azouzkm/CO2-Hypoventilation-Monitor/docs/screenshots/README.md

# Dashboard screenshots (4 Nov 2026), one per display state

Browser bar cropped off; everything on the page is kept. Times are the Mac clock.

| File | State | What it shows |
| --- | --- | --- |
| dashboard_01_standby.png | Standby (white, spinning) | Not monitoring yet; 735 ppm; line connected (21:40:00) |
| dashboard_02_standby_warming_up.png | Standby, sensor warming up | 500 ppm warm-up placeholder after a replug (22:13:59) |
| dashboard_03_breathing_normal.png | Normal (green) | Exhaled CO2 present, no alarm (21:40:21) |
| dashboard_04_co2_lost_critical.png | Critical (red), with Acknowledge | "CO2 lost: fell 498 ppm from 5000 in under 20 s" (21:41:31) |
| dashboard_05_co2_lost_acknowledged.png | Critical, acknowledged | Acknowledged by AKM on the screen; the monitor confirmed its sound is off (21:41:32) |
| dashboard_06_line_off_technical.png | Technical (cyan): line off, with Acknowledge | Safety clip open; never shown as a patient alarm (21:40:30) |
| dashboard_07_line_off_acknowledged.png | Line off, acknowledged on the screen | Box sound acknowledged only at its button (21:40:36) |
| dashboard_08_sensor_top_of_range_technical.png | Technical (cyan): sensor at top of range, with Acknowledge | 5,000 ppm for 30 s: "the sensor cannot see breaths" (21:41:11) |
| dashboard_09_sensor_top_of_range_acknowledged.png | Top of range, acknowledged on the screen | (21:41:14) |
| dashboard_10_advisory_recorded_3nov.png | Advisory (amber), with Acknowledge | The advisory recorded on 3 Nov 2026, 18:36: "CO2 down 35 % (4847 -> 3653 ppm), for 30 s" |
| dashboard_11_advisory_recorded_3nov_acknowledged.png | Advisory, acknowledged on the screen | Same recorded advisory; sound off on the screen for 2 min |

Note: images 05, 09 and 11 have the macOS screenshot preview in the bottom-right corner, over the right end of the 10-minute chart.
