azouzkm/CO2-Hypoventilation-Monitor/docs/photos/2026-11-01_inside_case_clip_first_try.jpg

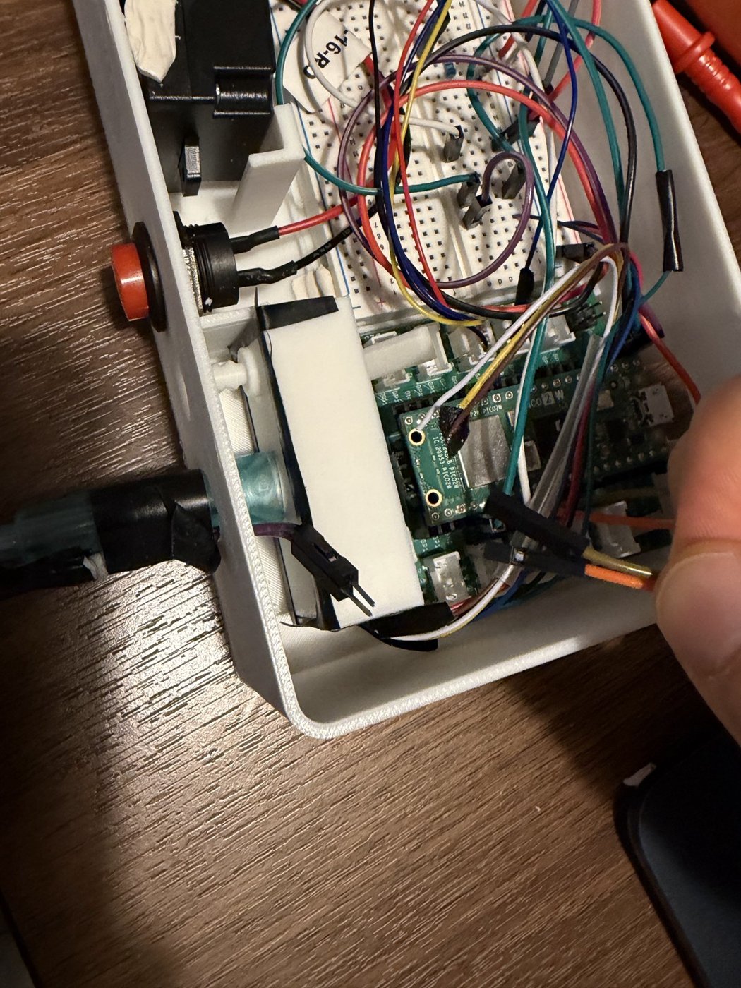
docs/photos/2026-11-01_inside_case_clip_first_try.jpg
