azouzkm/CO2-Hypoventilation-Monitor/docs/photos/2026-11-01_safety_clip_outside_front_panel.jpg

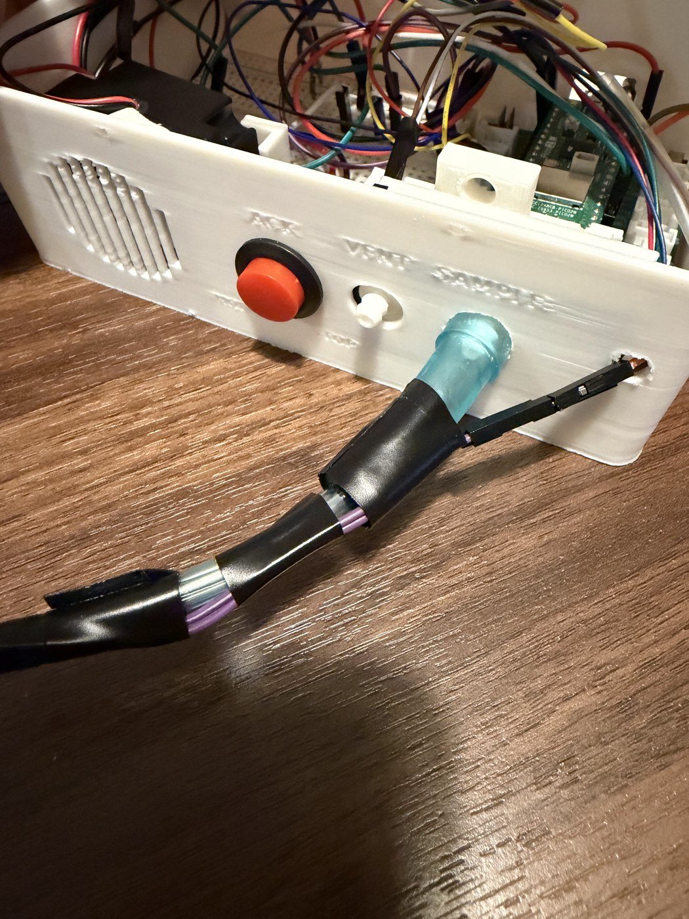
docs/photos/2026-11-01_safety_clip_outside_front_panel.jpg
