azouzkm/CO2-Hypoventilation-Monitor/docs/photos/2026-11-01_safety_clip_wires_to_shield.jpg

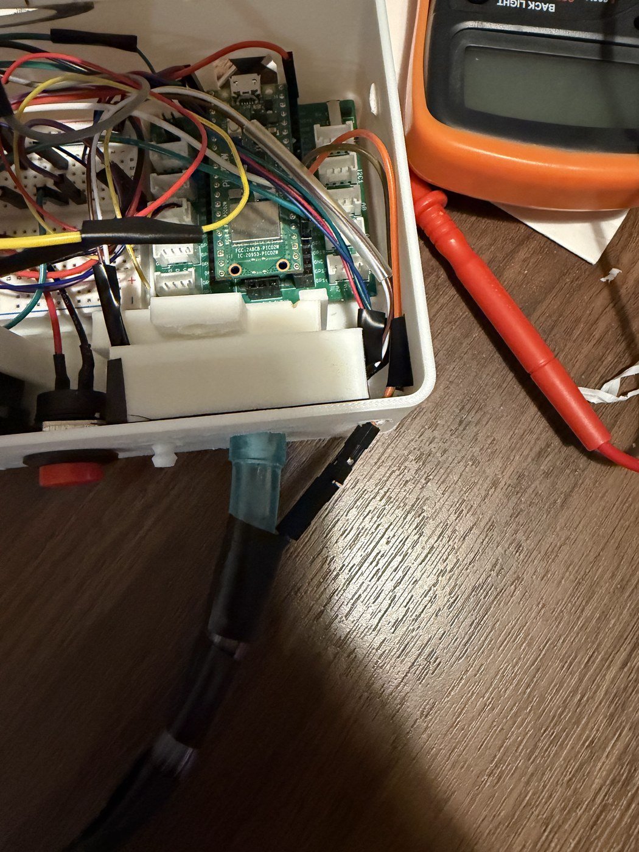
docs/photos/2026-11-01_safety_clip_wires_to_shield.jpg
