azouzkm/CO2-Hypoventilation-Monitor/docs/screenshots/dashboard_01_standby.png

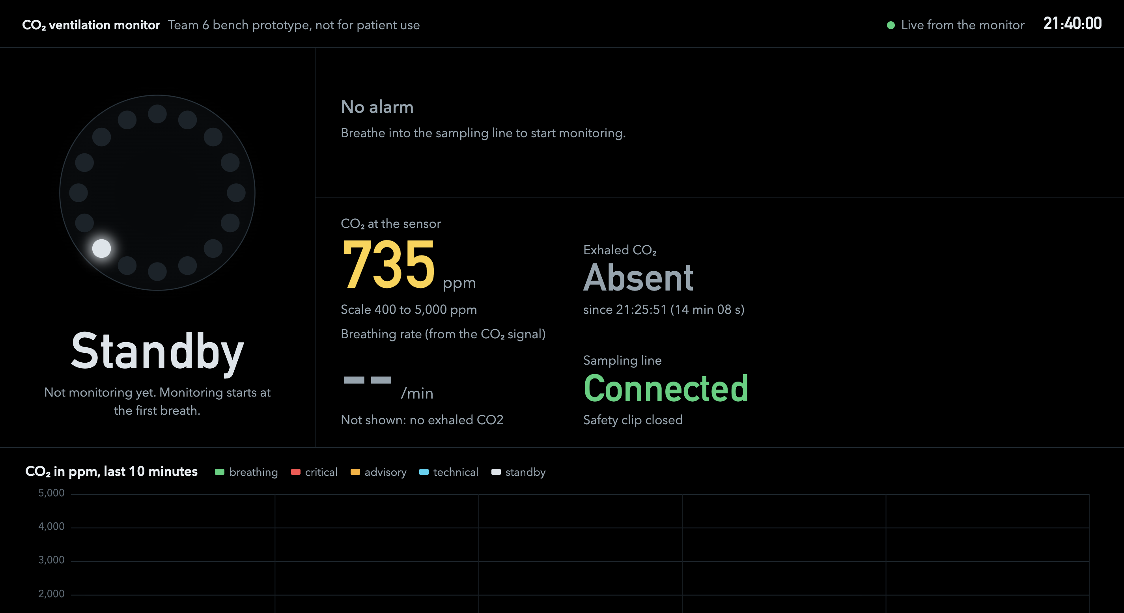
docs/screenshots/dashboard_01_standby.png
