azouzkm/CO2-Hypoventilation-Monitor/docs/screenshots/dashboard_02_standby_warming_up.png

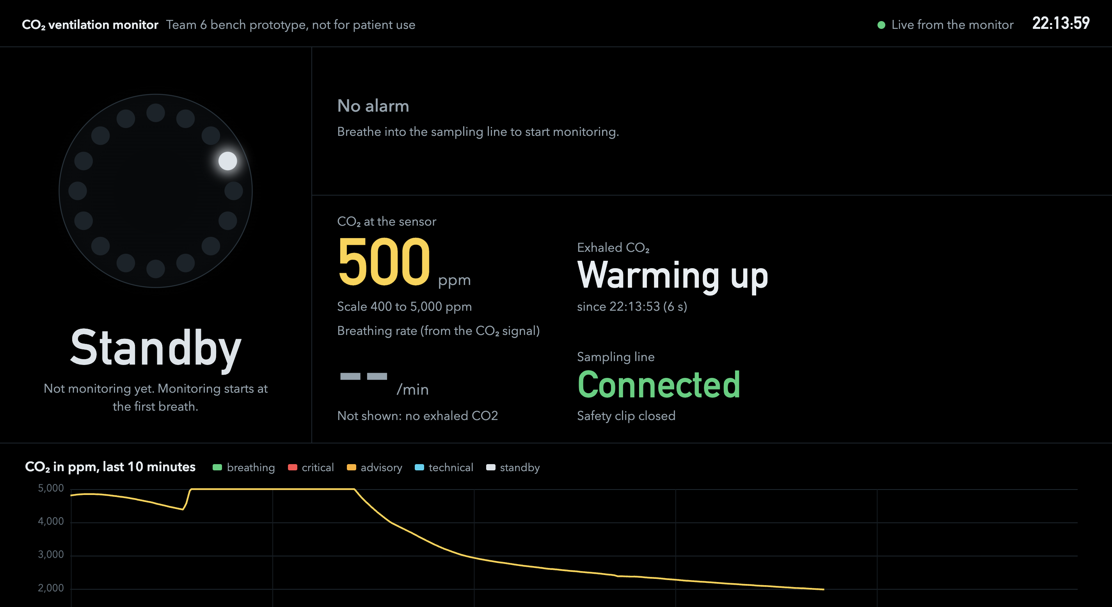
docs/screenshots/dashboard_02_standby_warming_up.png
