azouzkm/CO2-Hypoventilation-Monitor/docs/screenshots/dashboard_03_breathing_normal.png

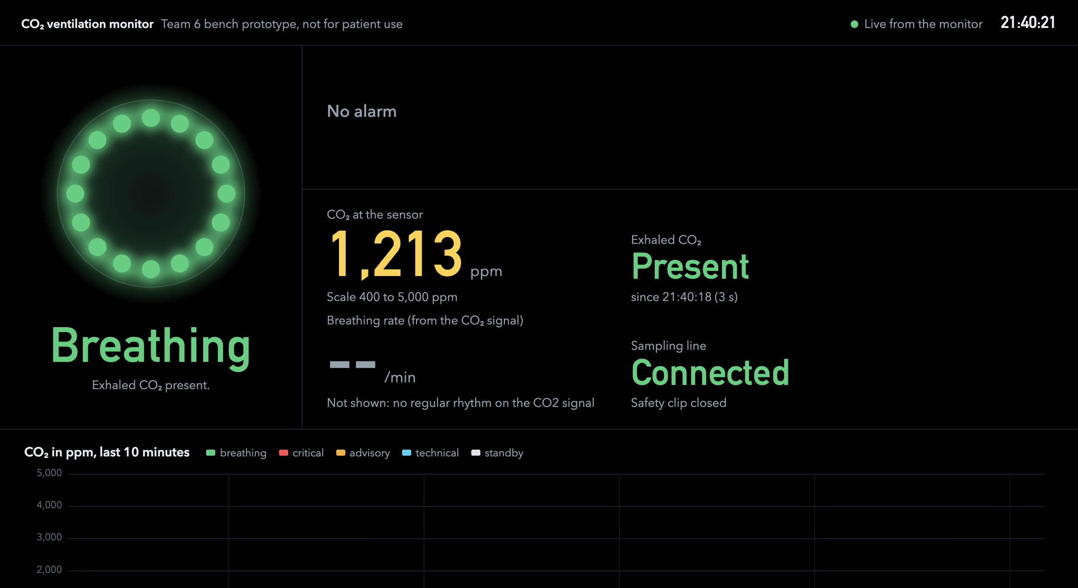
docs/screenshots/dashboard_03_breathing_normal.png
