azouzkm/CO2-Hypoventilation-Monitor/docs/screenshots/dashboard_04_co2_lost_critical.png

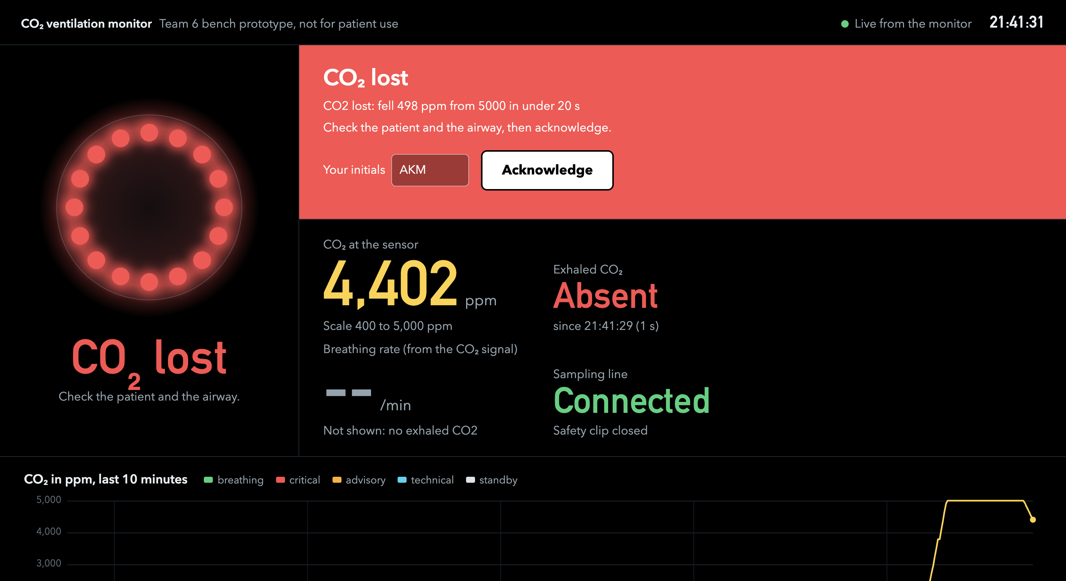
docs/screenshots/dashboard_04_co2_lost_critical.png
