azouzkm/CO2-Hypoventilation-Monitor/docs/screenshots/dashboard_05_co2_lost_acknowledged.png

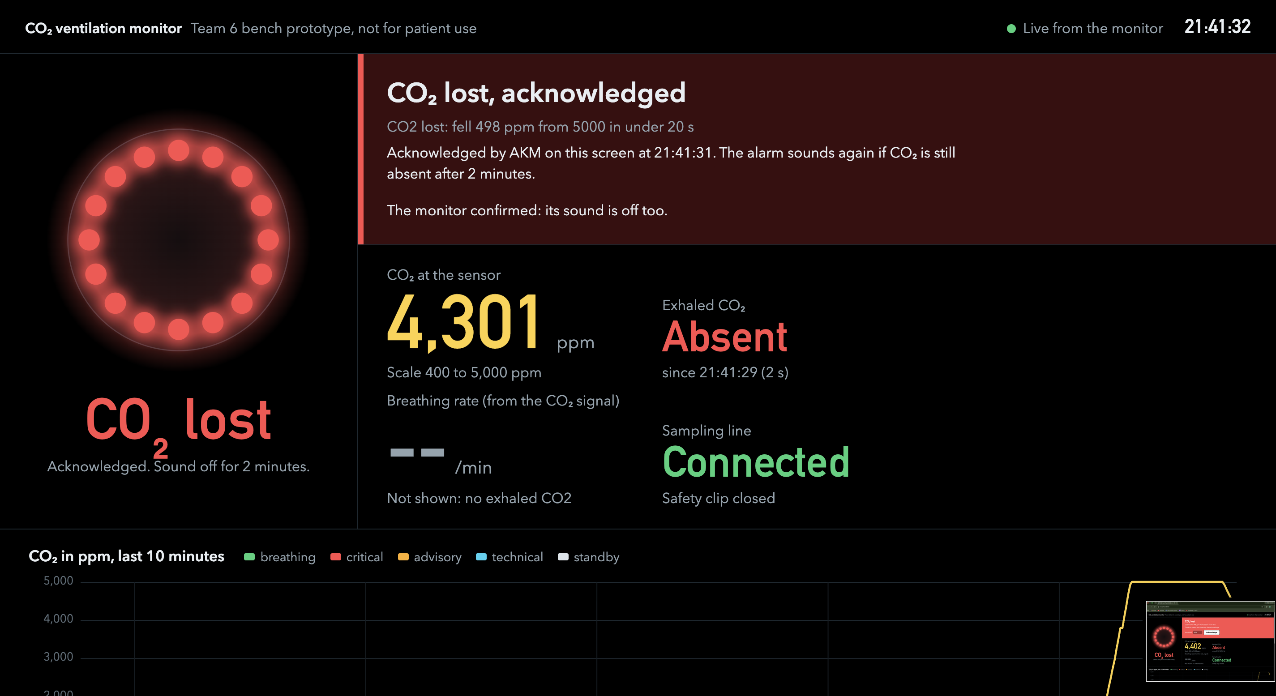
docs/screenshots/dashboard_05_co2_lost_acknowledged.png
