azouzkm/CO2-Hypoventilation-Monitor/docs/screenshots/dashboard_06_line_off_technical.png

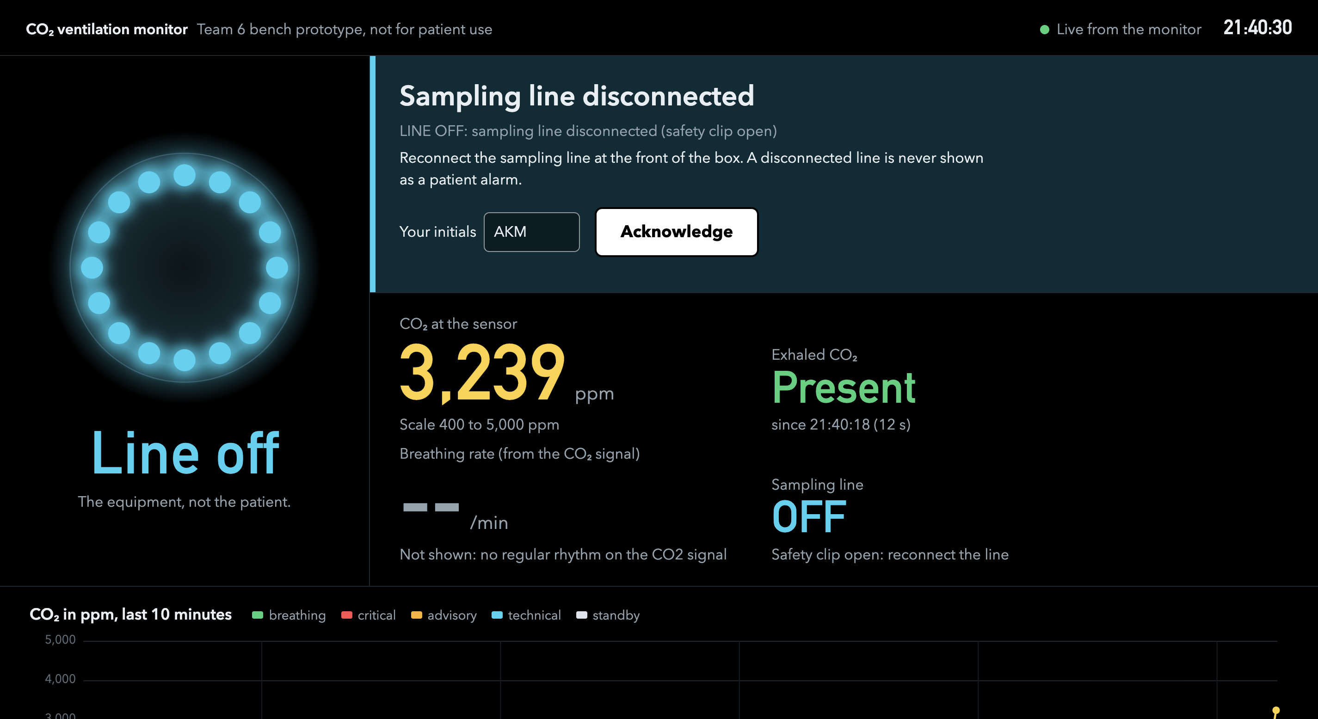
docs/screenshots/dashboard_06_line_off_technical.png
