azouzkm/CO2-Hypoventilation-Monitor/docs/screenshots/dashboard_07_line_off_acknowledged.png

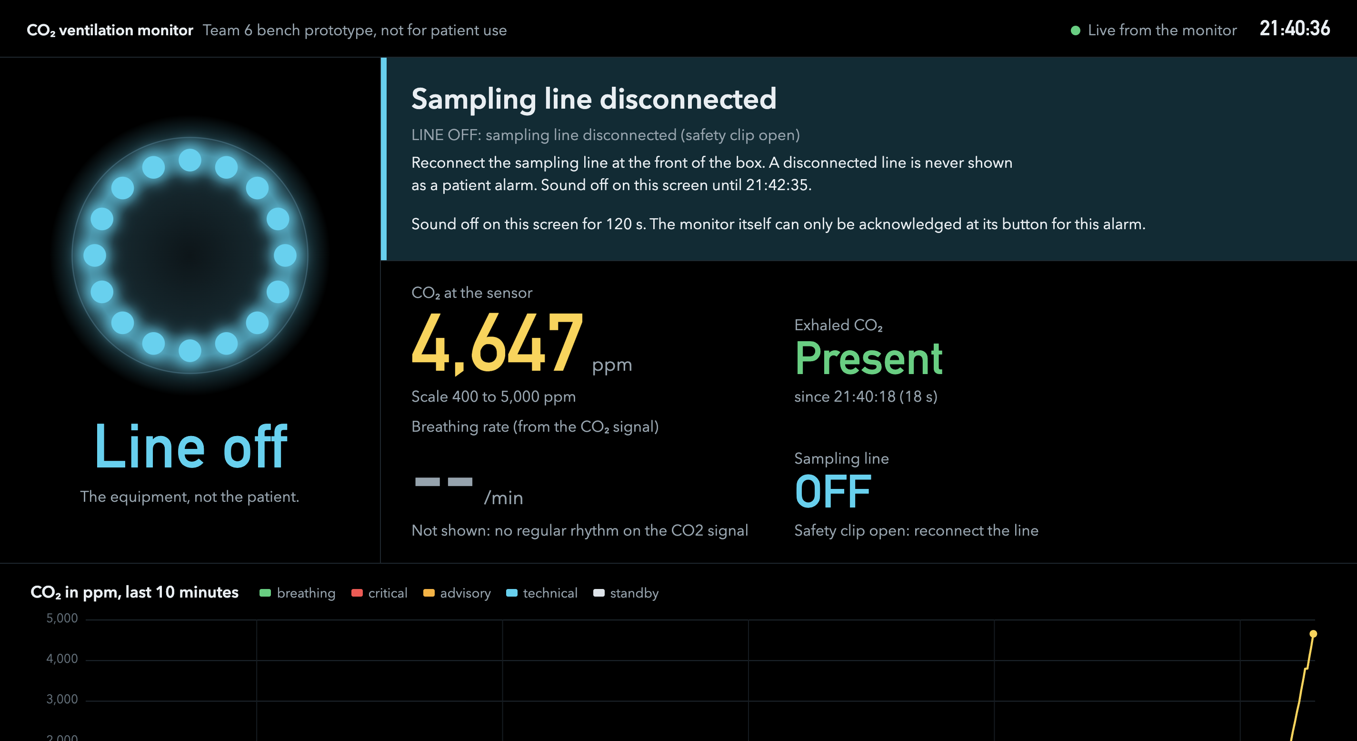
docs/screenshots/dashboard_07_line_off_acknowledged.png
