azouzkm/CO2-Hypoventilation-Monitor/docs/screenshots/dashboard_08_sensor_top_of_range_technical.png

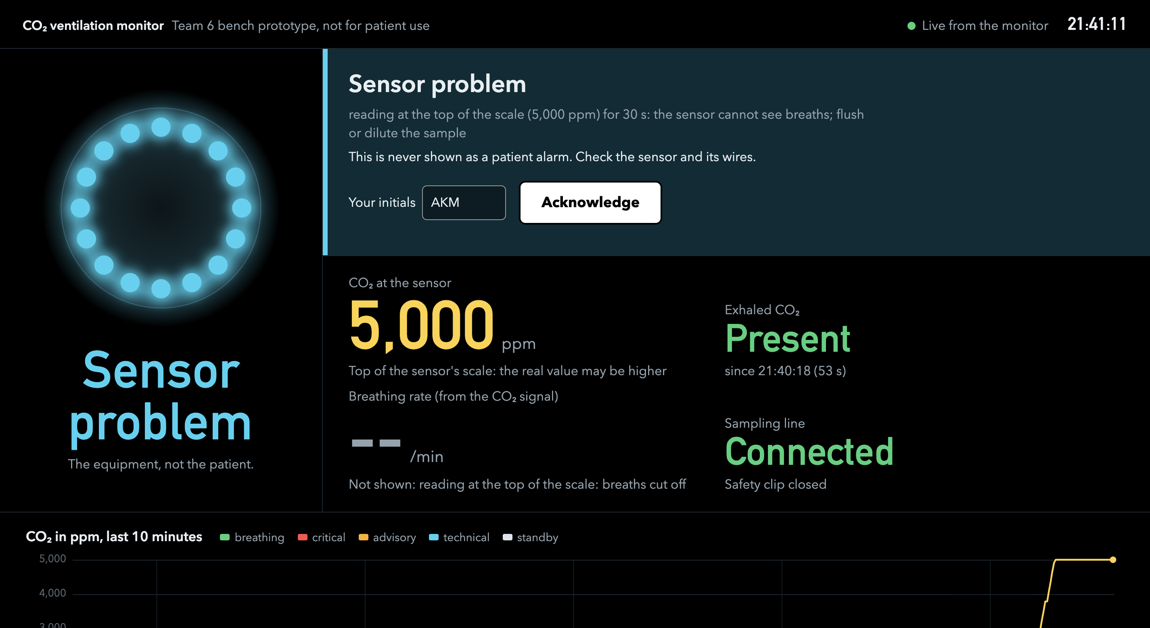
docs/screenshots/dashboard_08_sensor_top_of_range_technical.png
