azouzkm/CO2-Hypoventilation-Monitor/docs/screenshots/dashboard_09_sensor_top_of_range_acknowledged.png

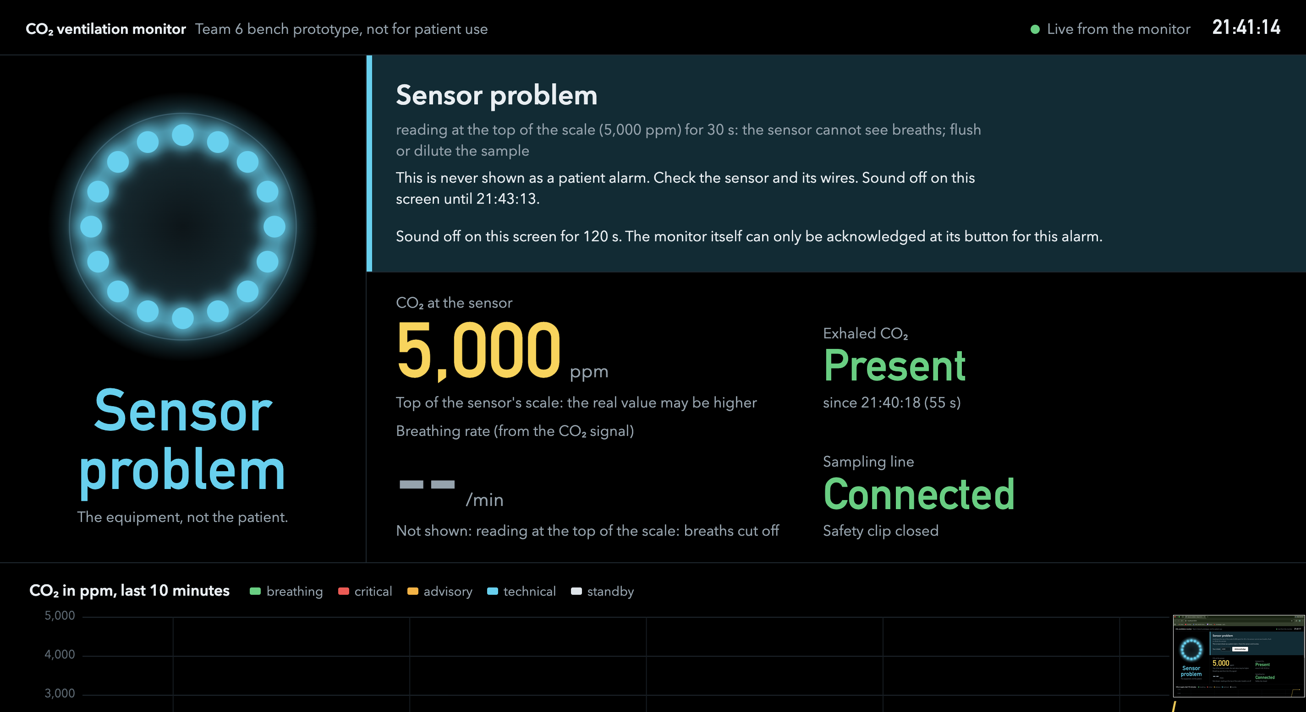
docs/screenshots/dashboard_09_sensor_top_of_range_acknowledged.png
