azouzkm/CO2-Hypoventilation-Monitor/docs/screenshots/dashboard_10_advisory_recorded_3nov.png

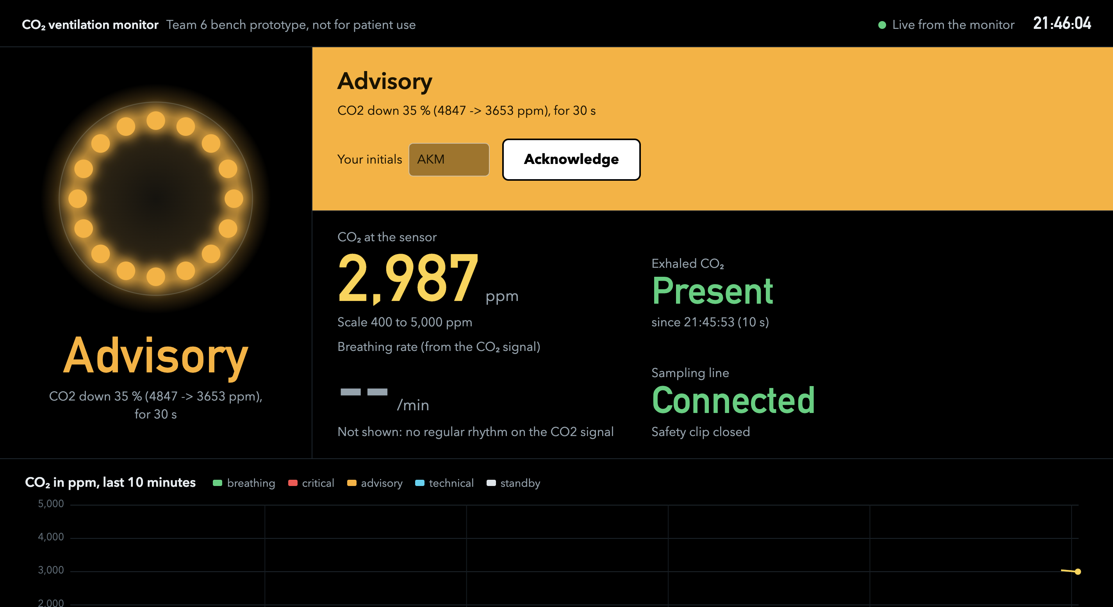
docs/screenshots/dashboard_10_advisory_recorded_3nov.png
