azouzkm/CO2-Hypoventilation-Monitor/docs/screenshots/dashboard_11_advisory_recorded_3nov_acknowledged.png

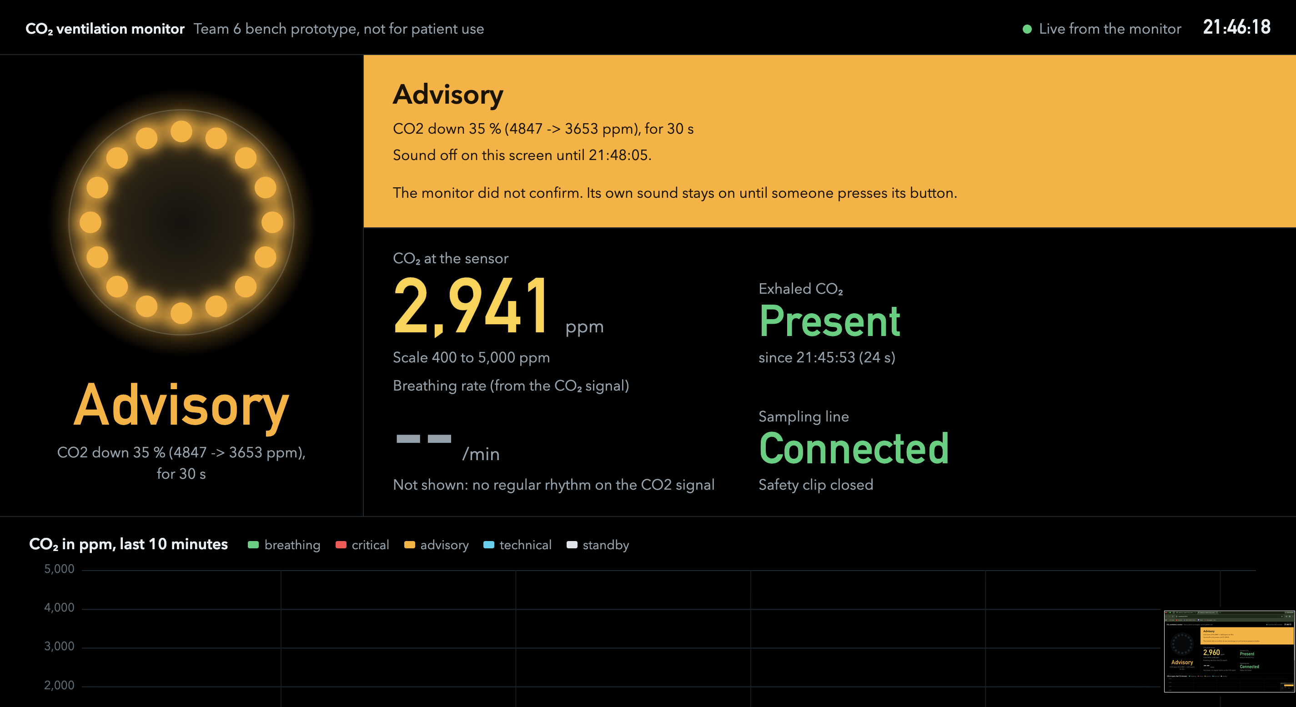
docs/screenshots/dashboard_11_advisory_recorded_3nov_acknowledged.png
