azouzkm/CO2-Hypoventilation-Monitor/hardware/cad/T6_cell_clamp_v1.step

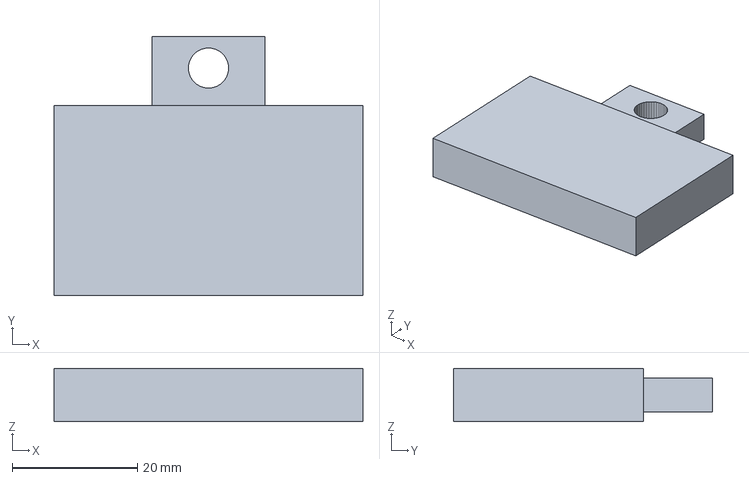
[picture p16: CAD file, 2026-11-05]
hardware/cad/T6_cell_clamp_v1.step
49.3 x 41.2 x 8.50 mm
