azouzkm/CO2-Hypoventilation-Monitor/hardware/cad/T6_light_cap_v1.step

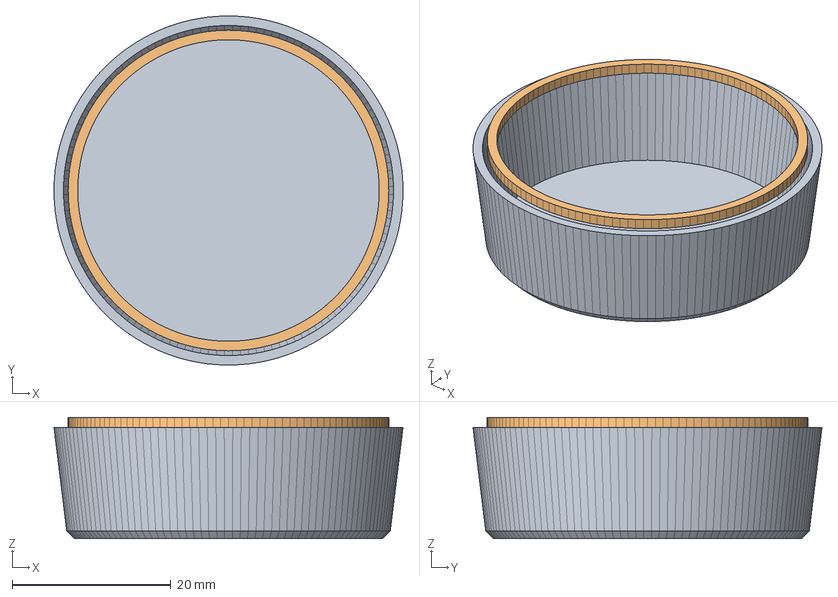
[picture p17: CAD file, 2026-11-05]
hardware/cad/T6_light_cap_v1.step
44.0 x 44.0 x 15.3 mm
