azouzkm/CO2-Hypoventilation-Monitor/hardware/cad/T6_caseA_lid_v1.step

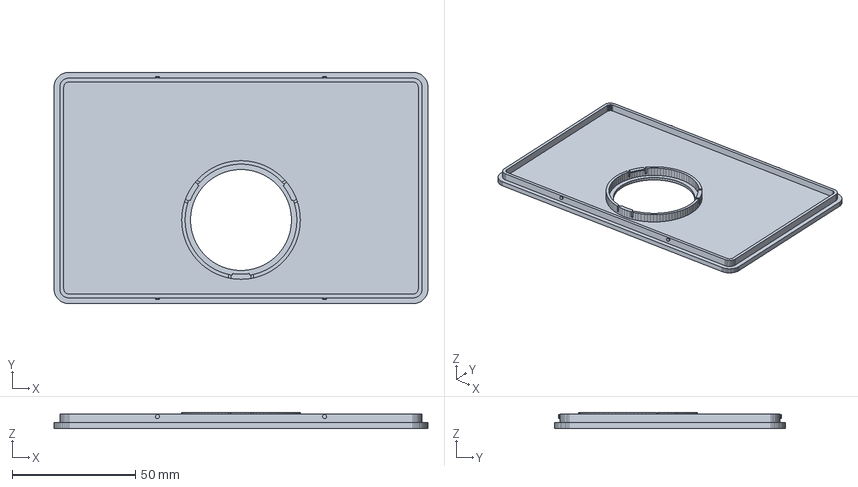
[picture p18: CAD file, 2026-11-05]
hardware/cad/T6_caseA_lid_v1.step
152.0 x 94.0 x 6.60 mm
