azouzkm/CO2-Hypoventilation-Monitor/hardware/cad/T6_caseA_base_v1.step

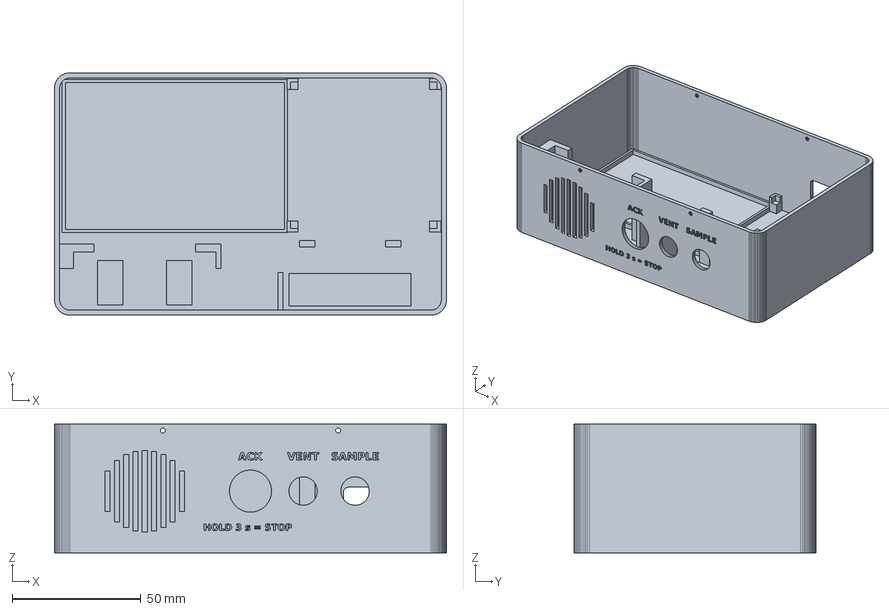
[picture p19: CAD file, 2026-11-05]
hardware/cad/T6_caseA_base_v1.step
152.0 x 94.0 x 50.0 mm
