azouzkm/CO2-Hypoventilation-Monitor/hardware/cad/T6_tpiece_v1.step

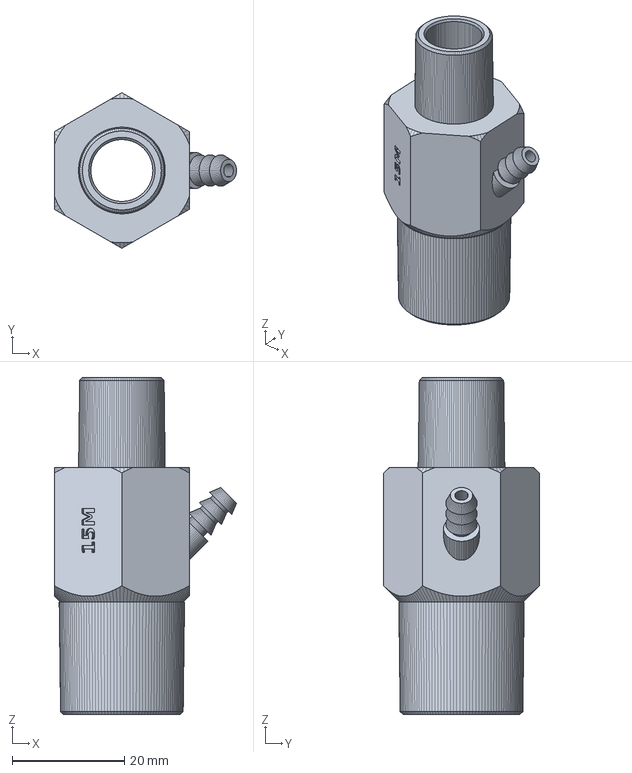
[picture p20: CAD file, 2026-11-05]
hardware/cad/T6_tpiece_v1.step
32.4 x 27.7 x 60.0 mm
