azouzkm/CO2-Hypoventilation-Monitor/data/runs/results.csv

date | time | label | rate_per_min | cues | present_s | present_breath | er1 | absent_s | er2 | peak_ppm | dropouts | valid | log
2026-11-02 | 21:24:51 | len050-t1 | 15 | 1 | 12 | 1 | PASS | 41 | FAIL | 1735 | 0 | valid | run_2026-11-02_212323_len050-t1.log
2026-11-02 | 21:32:06 | len050-t2 | 15 | 1 | 11 | 1 | PASS | 43 | FAIL | 1453 | 0 | valid | run_2026-11-02_213038_len050-t2.log
2026-11-02 | 21:38:15 | len050-t3 | 15 | 1 | 8 | 1 | PASS | 37 | FAIL | 2321 | 0 | valid | run_2026-11-02_213647_len050-t3.log
2026-11-02 | 21:45:21 | len100-t1 | 15 | 1 | 5 | 1 | PASS | 54 | FAIL | 2574 | 0 | valid | run_2026-11-02_214353_len100-t1.log
2026-11-02 | 21:51:04 | len100-t1 | 15 | 1 |  |  | FAIL |  | FAIL | 1134 | 0 | valid | run_2026-11-02_214936_len100-t1.log
2026-11-02 | 21:54:23 | len100-t1 | 15 | 1 | 58 | 1 | PASS |  | FAIL | 1213 | 0 | valid | run_2026-11-02_215255_len100-t1.log
2026-11-02 | 21:57:16 | len100-t1 | 15 | 1 |  |  | FAIL |  | FAIL | 1079 | 0 | valid | run_2026-11-02_215548_len100-t1.log
2026-11-02 | 22:03:25 | len100-t1 | 15 | 1 |  |  | FAIL |  | FAIL | 1214 | 0 | valid | run_2026-11-02_220157_len100-t1.log
2026-11-02 | 22:08:00 | len100-t1 | 15 | 1 | 12 | 1 | PASS |  | FAIL | 1349 | 0 | valid | run_2026-11-02_220631_len100-t1.log
2026-11-02 | 22:11:39 | len100-t1 | 15 | 1 | 24 | 1 | PASS |  | FAIL | 1405 | 0 | valid | run_2026-11-02_221011_len100-t1.log
2026-11-02 | 22:35:55 | len050-leakcheck | 15 | 1 | 16 | 1 | PASS | 47 | FAIL | 1379 | 0 | valid | run_2026-11-02_223427_len050-leakcheck.log
2026-11-02 | 23:42:18 | len100-t1 | 15 | 1 | 8 | 1 | PASS | 39 | FAIL | 4801 | 0 | valid | run_2026-11-02_234050_len100-t1.log
2026-11-02 | 23:45:56 | len100-t2 | 15 | 1 | 8 | 1 | PASS | 31 | FAIL | 2350 | 0 | valid | run_2026-11-02_234428_len100-t2.log
2026-11-02 | 23:48:45 | len100-t3 | 15 | 1 | 9 | 1 | PASS | 29 | PASS | 2153 | 0 | valid | run_2026-11-02_234717_len100-t3.log
2026-11-02 | 23:53:27 | len050s-t1 | 15 | 1 | 13 | 1 | PASS | 40 | FAIL | 2040 | 0 | valid | run_2026-11-02_235159_len050s-t1.log
2026-11-02 | 23:56:21 | len050s-t1 | 15 | 1 | 7 | 1 | PASS | 36 | FAIL | 3846 | 0 | valid | run_2026-11-02_235453_len050s-t1.log
2026-11-02 | 23:59:14 | len050s-t2 | 15 | 1 | 7 | 1 | PASS | 35 | FAIL | 3472 | 0 | valid | run_2026-11-02_235746_len050s-t2.log
2026-11-03 | 00:02:04 | len050s-t3 | 15 | 1 | 8 | 1 | PASS | 36 | FAIL | 3399 | 0 | valid | run_2026-11-03_000036_len050s-t3.log
2026-11-03 | 00:08:40 | len210-t1 | 15 | 1 | 24 | 1 | PASS | 58 | FAIL | 3757 | 0 | valid | run_2026-11-03_000712_len210-t1.log
2026-11-03 | 00:12:25 | len210-t2 | 15 | 1 | 22 | 1 | PASS | 51 | FAIL | 3680 | 0 | valid | run_2026-11-03_001027_len210-t2.log
2026-11-03 | 00:16:16 | len210-t3 | 15 | 1 | 24 | 1 | PASS | 49 | FAIL | 1950 | 0 | valid | run_2026-11-03_001418_len210-t3.log
2026-11-03 | 00:20:23 | len100-t4 | 15 | 1 | 14 | 1 | PASS | 41 | FAIL | 2700 | 0 | valid | run_2026-11-03_001855_len100-t4.log
2026-11-03 | 00:23:28 | len100-t5 | 15 | 1 | 19 | 1 | PASS | 44 | FAIL | 1903 | 0 | valid | run_2026-11-03_002159_len100-t5.log
2026-11-03 | 00:25:48 | len100-t6 | 15 | 1 | 21 | 1 | PASS | 54 | FAIL | 2341 | 0 | valid | run_2026-11-03_002420_len100-t6.log
2026-11-03 | 17:56:04 | mask-run01 | 15 | 15 | 70 | 15 | FAIL |  | FAIL | 1446 | 0 | excluded | run_2026-11-03_175400_mask-run01.log
2026-11-03 | 18:00:19 | bare-run01 | 15 | 15 | 21 | 6 | FAIL |  | FAIL | 5000 | 0 | excluded | run_2026-11-03_175815_bare-run01.log
2026-11-03 | 18:08:29 | t5-run01 | 15 | 10 | 63 | 10 | FAIL |  | FAIL | 2993 | 0 | excluded | run_2026-11-03_180645_t5-run01.log
2026-11-03 | 18:12:48 | t5-run01 | 15 | 10 | 26 | 7 | FAIL |  | FAIL | 5000 | 0 | excluded | run_2026-11-03_181104_t5-run01.log
2026-11-04 | 19:01:36 | t5-run01 | 15 | 10 | 6 | 2 | PASS | 24 | PASS | 5000 | 0 | valid | run_2026-11-04_185932_t5-run01.log
2026-11-04 | 19:06:01 | t5-run02 | 15 | 10 | 9 | 3 | PASS | 21 | PASS | 2228 | 0 | valid | run_2026-11-04_190357_t5-run02.log
2026-11-04 | 19:11:42 | t5-run03 | 15 | 10 | 14 | 4 | FAIL | 20 | PASS | 1523 | 0 | excluded | run_2026-11-04_190938_t5-run03.log
2026-11-04 | 19:17:05 | t5-run04 | 15 | 10 | 6 | 2 | PASS |  | FAIL | 2878 | 1 | excluded | run_2026-11-04_191500_t5-run04.log
2026-11-04 | 19:23:12 | t5-run03 | 15 | 10 | 7 | 2 | PASS | 15 | PASS | 5000 | 0 | valid | run_2026-11-04_192107_t5-run03.log
2026-11-04 | 19:27:00 | t5-run04 | 15 | 10 | 7 | 2 | PASS | 15 | PASS | 3598 | 0 | valid | run_2026-11-04_192456_t5-run04.log
2026-11-04 | 19:35:35 | t5-run05 | 15 | 10 | 8 | 3 | PASS | 33 | FAIL | 5000 | 0 | valid | run_2026-11-04_193331_t5-run05.log
2026-11-04 | 19:48:16 | t5-run06 | 15 | 10 | 6 | 2 | PASS | 16 | PASS | 3526 | 0 | valid | run_2026-11-04_194612_t5-run06.log
2026-11-04 | 19:51:49 | t5-run07 | 15 | 10 | 7 | 2 | PASS | 13 | PASS | 4167 | 0 | valid | run_2026-11-04_194945_t5-run07.log
2026-11-04 | 19:55:44 | t5-run08 | 15 | 10 | 8 | 3 | PASS | 8 | PASS | 3756 | 0 | valid | run_2026-11-04_195339_t5-run08.log
2026-11-04 | 20:00:08 | t5-run09 | 15 | 10 | 7 | 2 | PASS | 9 | PASS | 4595 | 0 | valid | run_2026-11-04_195804_t5-run09.log
2026-11-04 | 20:04:08 | t5-run10 | 15 | 10 | 8 | 3 | PASS | 13 | PASS | 3328 | 0 | valid | run_2026-11-04_200204_t5-run10.log
