azouzkm/CO2-Hypoventilation-Monitor/data/runs/tube_length_results.csv

tube_m | puller | label | log | baseline_ppm | breath_arrives_s | present_s | peak_s | peak_ppm | rise_ppm | critical_s
0.5 | AKM | len050s-t1 | run_2026-11-02_235453_len050s-t1.log | 1383 | 6 | 7 | 29 | 3846 | 2463 | 40
0.5 | AKM | len050s-t2 | run_2026-11-02_235746_len050s-t2.log | 1330 | 6 | 7 | 30 | 3472 | 2142 | 39
0.5 | AKM | len050s-t3 | run_2026-11-03_000036_len050s-t3.log | 1381 | 8 | 8 | 29 | 3399 | 2018 | 40
1.0 | AKM | len100-t4 | run_2026-11-03_001855_len100-t4.log | 1174 | 13 | 14 | 35 | 2700 | 1526 | 45
1.0 | AKM | len100-t5 | run_2026-11-03_002159_len100-t5.log | 1206 | 18 | 19 | 37 | 1903 | 696 | 48
1.0 | AKM | len100-t6 | run_2026-11-03_002420_len100-t6.log | 1179 | 20 | 21 | 44 | 2341 | 1162 | 58
2.1 | AKM | len210-t1 | run_2026-11-03_000712_len210-t1.log | 1202 | 16 | 24 | 51 | 3757 | 2555 | 62
2.1 | AKM | len210-t2 | run_2026-11-03_001027_len210-t2.log | 1208 | 22 | 22 | 45 | 3680 | 2472 | 55
2.1 | AKM | len210-t3 | run_2026-11-03_001418_len210-t3.log | 1186 | 23 | 24 | 43 | 1950 | 764 | 53
