azouzkm/CO2-Hypoventilation-Monitor/(commit log)

2026-11-03 Bench tests 2-3 Nov: tests 1-4, 6, 7 recorded; leak found and sealed; dashboard shows breathing rate and sampling line
    [results.csv, tube_length_results.csv]
2026-11-05 Test 5 (10 runs), outdoor zero calibration, breathing-rate run and comparison, peak-count rate tool, dashboard screenshots, 4 Nov results
    [peak_rate_results.csv, rate_comparison.csv, rate_results.csv, response_10_90.csv, results.csv, rr_replay_2026-10-22.csv, test5_summary.csv]
2026-11-05 Final dossier PDF, Option A case STEP files, README and protocol fixes
2026-11-05 Dossier PDF and Option A case STEP files
    [T6_caseA_base_v1.step, T6_caseA_lid_v1.step, T6_cell_clamp_v1.step, T6_light_cap_v1.step, T6_tpiece_v1.step]
